kerikun11/ChargeStation/(list of files, drawings)

Other design files:
kicad/ChargeStation06.dsn
