kerikun11/ChargeStation/kicad/ChargeStation06.kicad_pcb

## KiCad design kicad/ChargeStation06.kicad_pcb (2019-02-26)

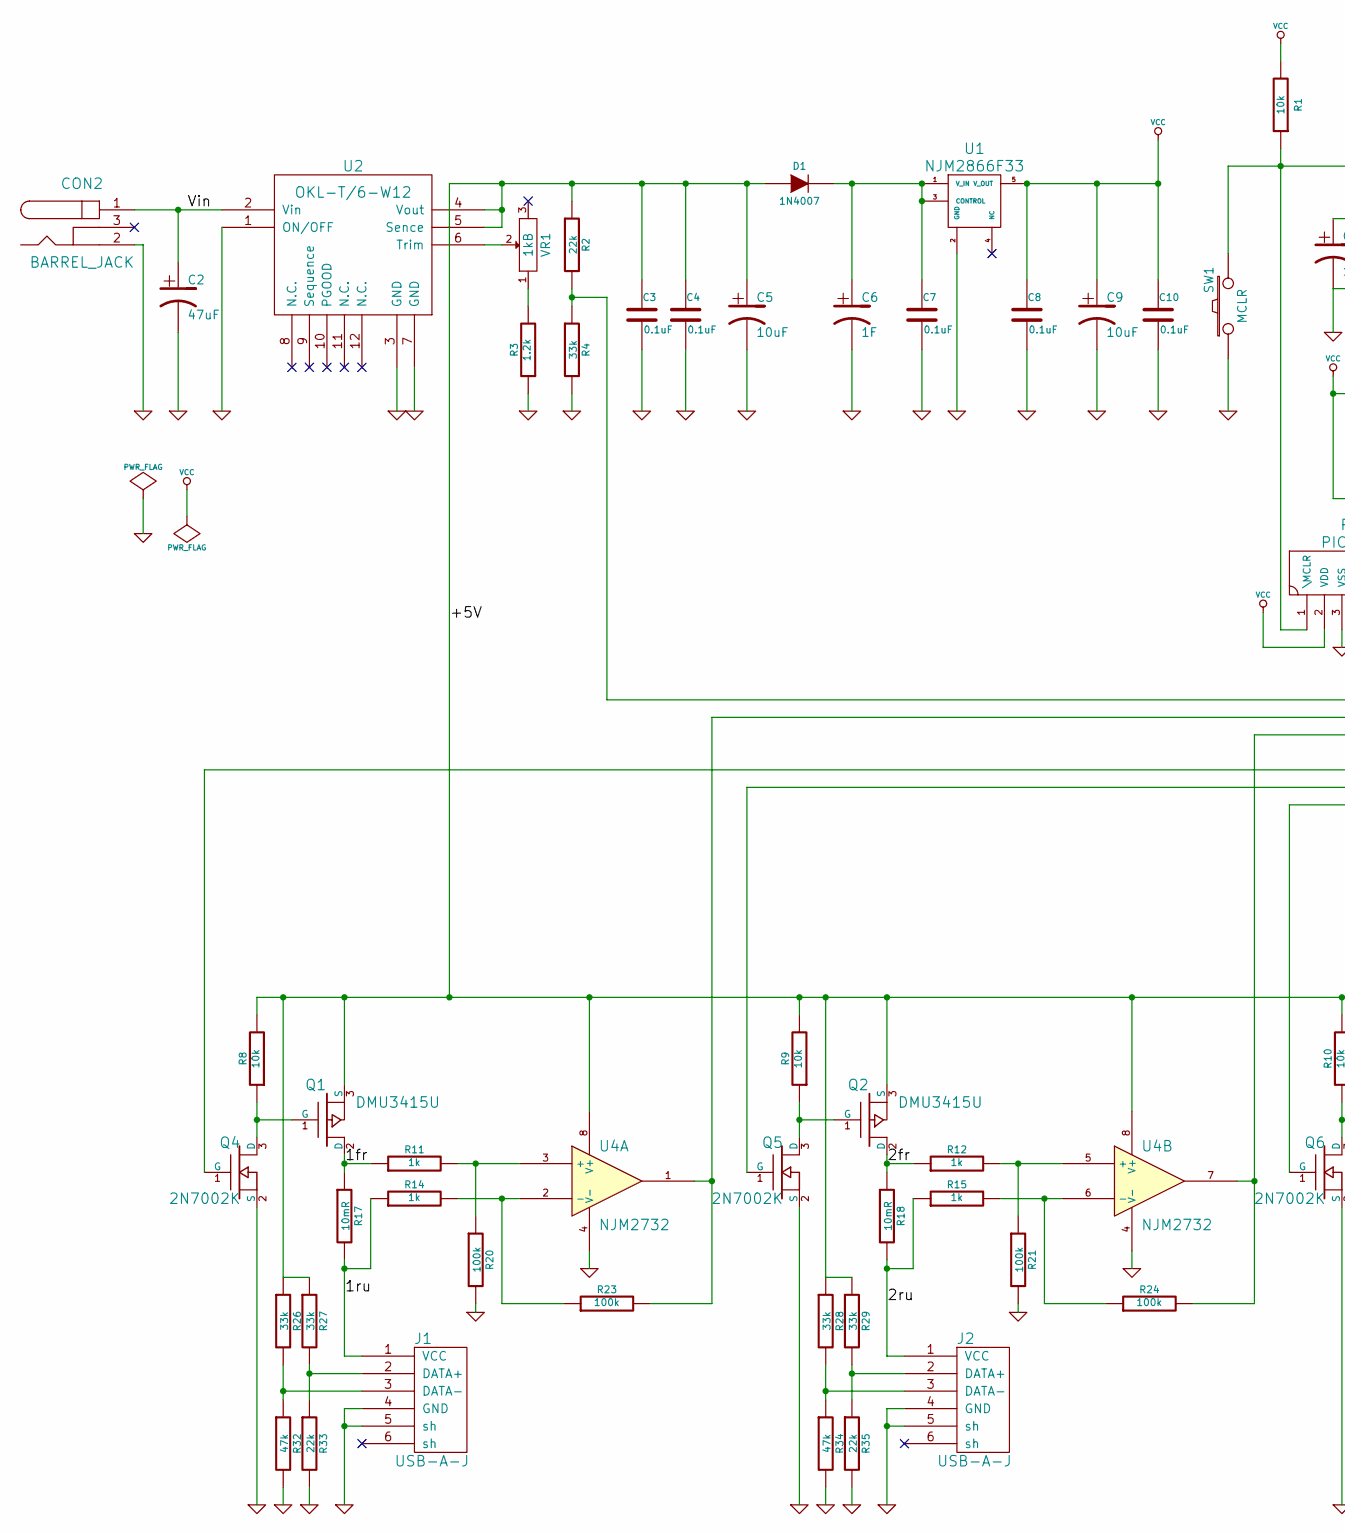
[picture p1: schematic ChargeStation06.sch, part in row 1, column 1]

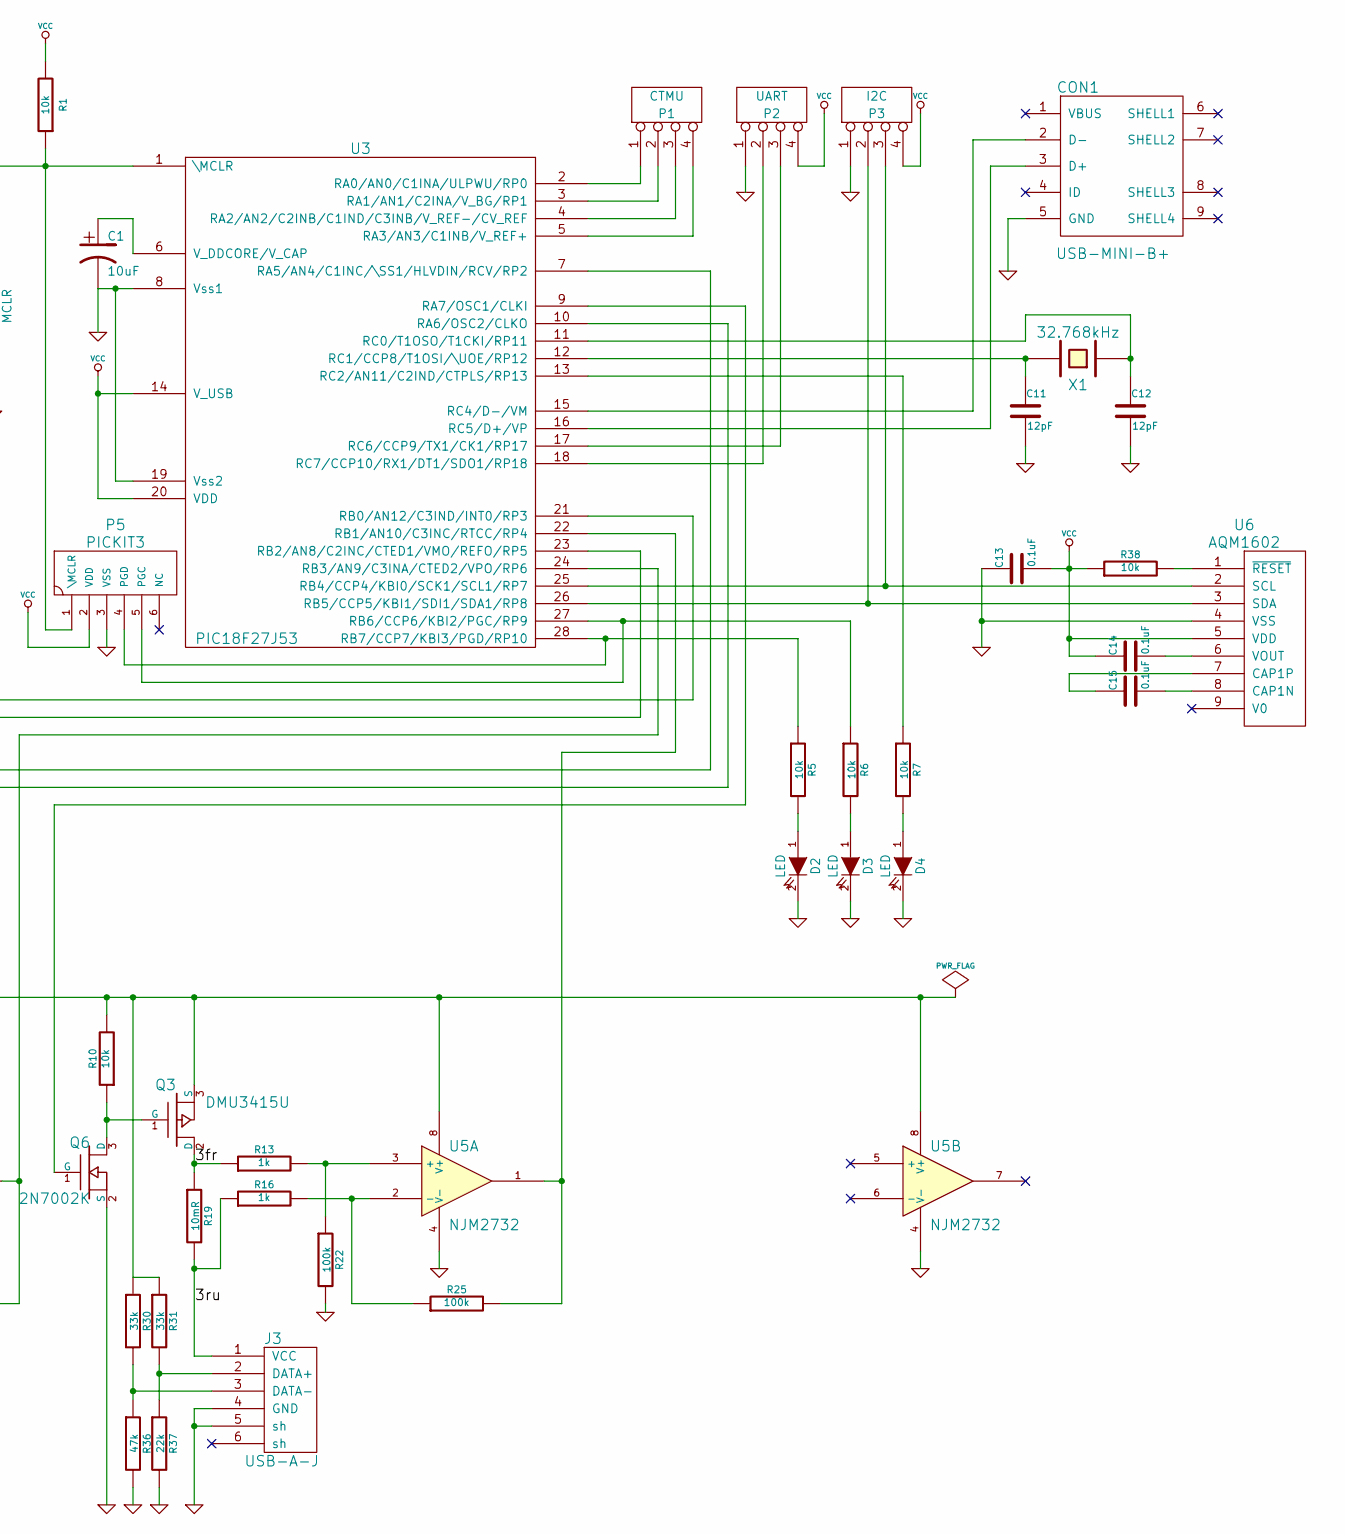
[picture p2: schematic ChargeStation06.sch, part in row 1, column 2]

Parts:
C1, C5, C9: 10uF
C2: 47uF
C3, C4, C7, C8, C10, C13, C14, C15: 0.1uF
C6: 1F
C11, C12: 12pF
CON1: USB-MINI-B+
CON2: BARREL_JACK
D1: 1N4007
D2, D3, D4: LED
J1, J2, J3: USB-A-J
P1: CTMU
P2: UART
P3: I2C
P5: PICKIT3
Q1, Q2, Q3: DMU3415U
Q4, Q5, Q6: 2N7002K
R1, R5, R6, R7, R8, R9, R10, R38: 10k
R2, R33, R35, R37: 22k
R3: 1.2k
R4, R26, R27, R28, R29, R30, R31: 33k
R11, R12, R13, R14, R15, R16: 1k
R17, R18, R19: 10mR
R20, R21, R22, R23, R24, R25: 100k
R32, R34, R36: 47k
SW1: MCLR
U1: NJM2866F33
U2: OKL-T/6-W12
U3: PIC18F27J53
U4, U5: NJM2732
U6: AQM1602
VR1: 1kB
X1: 32.768kHz

Connections:
/1fr: Q1.2 (D), R11.1, R17.1
/1ru: J1.1 (VCC), R14.1, R17.2
/2fr: Q2.2 (D), R12.1, R18.1
/2ru: J2.1 (VCC), R15.1, R18.2
/3fr: Q3.2 (D), R13.1, R19.1
/3ru: J3.1 (VCC), R16.1, R19.2
/+5V: C3.1, C4.1, C5.1, D1.1 (A), Q1.3 (S), Q2.3 (S), Q3.3 (S), R2.1, R8.2, R9.2, R10.2, R26.1, R27.1, R28.1, R29.1, R30.1, R31.1, U2.4 (Vout), U2.5 (Sence), U4.8 (V+), U5.8 (V+)
/Vin: C2.1, CON2.1, U2.2 (Vin)
GND: C1.2, C2.2, C3.2, C4.2, C5.2, C6.2, C7.2, C8.2, C9.2, C10.2, C11.2, C12.2, C13.1, CON1.5 (GND), CON2.2, D2.2 (K), D3.2 (K), D4.2 (K), J1.4 (GND), J1.5 (sh), J2.4 (GND), J2.5 (sh), J3.4 (GND), J3.5 (sh), P2.1, P3.1, P5.3 (VSS), Q4.2 (S), Q5.2 (S), Q6.2 (S), R3.1, R4.2, R20.2, R21.2, R22.2, R32.2, R33.2, R34.2, R35.2, R36.2, R37.2, SW1.1, U1.2 (GND), U2.1 (ON/OFF), U2.3 (GND), U2.7 (GND), U3.8 (Vss1), U3.19 (Vss2), U4.4 (V-), U5.4 (V-), U6.4 (VSS)
unnamed: J3.3 (DATA-), R30.2, R36.1
unnamed: J3.2 (DATA+), R31.2, R37.1
unnamed: R13.2, R22.1, U5.3 (+)
unnamed: Q2.1 (G), Q5.3 (D), R9.1
unnamed: R24.2, U3.24 (RB3/AN9/C3INA/CTED2/VPO/RP6), U4.7
unnamed: R15.2, R24.1, U4.6 (-)
unnamed: Q3.1 (G), Q6.3 (D), R10.1
unnamed: R25.2, U3.22 (RB1/AN10/C3INC/RTCC/RP4), U5.1
unnamed: R16.2, R25.1, U5.2 (-)
unnamed: Q1.1 (G), Q4.3 (D), R8.1
unnamed: R23.2, U3.23 (RB2/AN8/C2INC/CTED1/VMO/REFO/RP5), U4.1
unnamed: R14.2, R23.1, U4.2 (-)
unnamed: R2.2, R4.1, U3.21 (RB0/AN12/C3IND/INT0/RP3)
unnamed: J2.3 (DATA-), R28.2, R34.1
unnamed: J2.2 (DATA+), R29.2, R35.1
unnamed: R12.2, R21.1, U4.5 (+)
unnamed: Q6.1 (G), U3.9 (RA7/OSC1/CLKI)
unnamed: CON1.2 (D-), U3.15 (RC4/D-/VM)
unnamed: R7.1, U3.13 (RC2/AN11/C2IND/CTPLS/RP13)
unnamed: P2.3, U3.17 (RC6/CCP9/TX1/CK1/RP17)
unnamed: P2.2, U3.18 (RC7/CCP10/RX1/DT1/SDO1/RP18)
unnamed: Q5.1 (G), U3.10 (RA6/OSC2/CLKO)
unnamed: Q4.1 (G), U3.7 (RA5/AN4/C1INC/\SS1/HLVDIN/RCV/RP2)
unnamed: P1.1, U3.2 (RA0/AN0/C1INA/ULPWU/RP0)
unnamed: P1.2, U3.3 (RA1/AN1/C2INA/V_BG/RP1)
unnamed: P1.4, U3.5 (RA3/AN3/C1INB/V_REF+)
unnamed: P5.1 (\MCLR), R1.1, SW1.2, U3.1 (\MCLR)
unnamed: P5.4 (PGD), R5.1, U3.28 (RB7/CCP7/KBI3/PGD/RP10)
unnamed: C1.1, U3.6 (V_DDCORE/V_CAP)
unnamed: C11.1, U3.12 (RC1/CCP8/T1OSI/\UOE/RP12), X1.2
unnamed: P5.5 (PGC), R6.1, U3.27 (RB6/CCP6/KBI2/PGC/RP9)
unnamed: C15.1, U6.7 (CAP1P)
unnamed: P3.3, U3.25 (RB4/CCP4/KBI0/SCK1/SCL1/RP7), U6.2 (SCL)
unnamed: P3.2, U3.26 (RB5/CCP5/KBI1/SDI1/SDA1/RP8), U6.3 (SDA)
unnamed: R38.2, U6.1 (~RESET)
unnamed: C14.2, U6.6 (VOUT)
unnamed: C15.2, U6.8 (CAP1N)
unnamed: J1.2 (DATA+), R27.2, R33.1
unnamed: J1.3 (DATA-), R26.2, R32.1
unnamed: R11.2, R20.1, U4.3 (+)
unnamed: P1.3, U3.4 (RA2/AN2/C2INB/C1IND/C3INB/V_REF-/CV_REF)
unnamed: D3.1 (A), R6.2
unnamed: CON1.3 (D+), U3.16 (RC5/D+/VP)
unnamed: U2.6 (Trim), VR1.2
unnamed: D2.1 (A), R5.2
unnamed: D4.1 (A), R7.2
unnamed: R3.2, VR1.1
unnamed: C6.1, C7.1, D1.2 (K), U1.1 (V_IN), U1.3 (CONTROL)
unnamed: C12.1, U3.11 (RC0/T1OSO/T1CKI/RP11), X1.1
VCC: C8.1, C9.1, C10.1, C13.2, C14.1, P2.4, P3.4, P5.2 (VDD), R1.2, R38.1, U1.5 (V_OUT), U3.14 (V_USB), U3.20 (VDD), U6.5 (VDD)

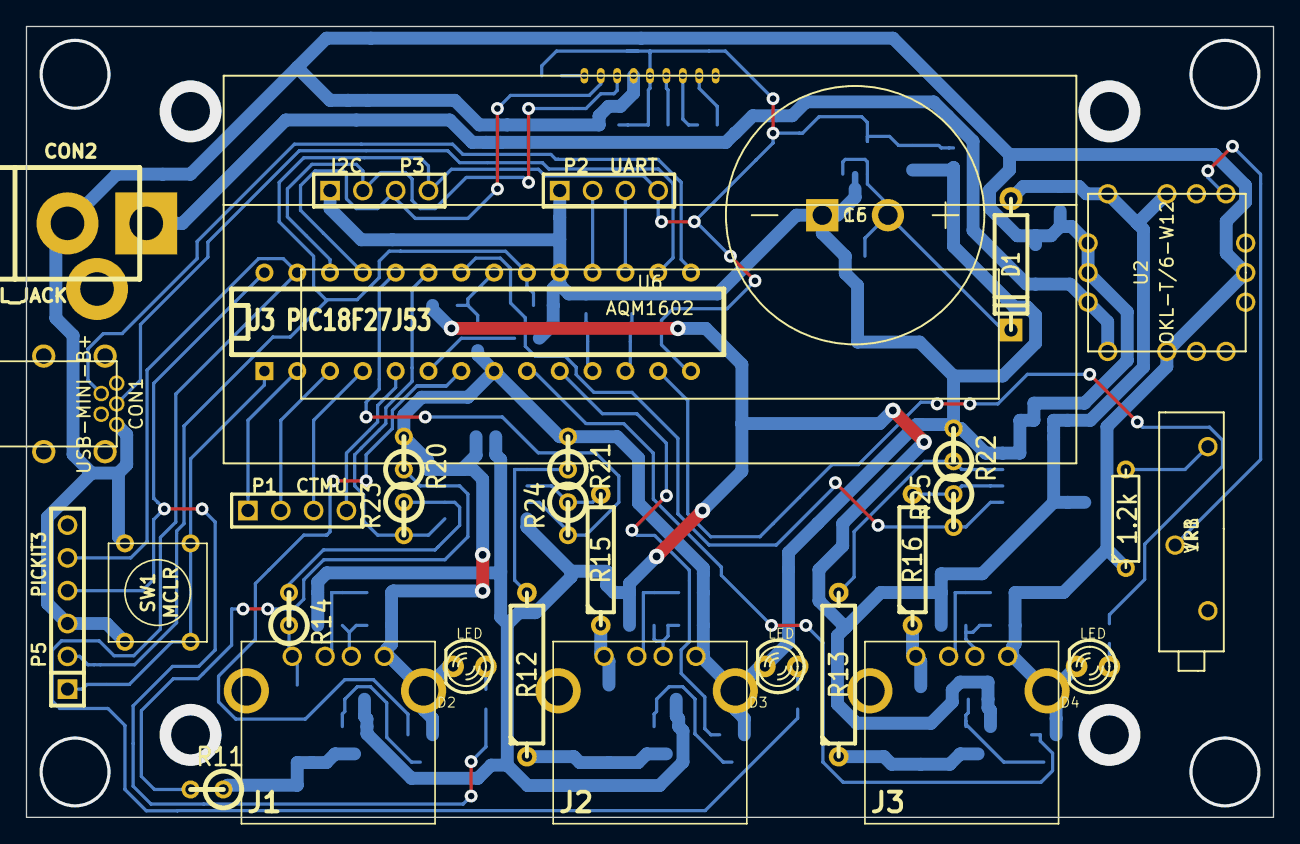
[picture p3: board ChargeStation06.kicad_pcb from above]

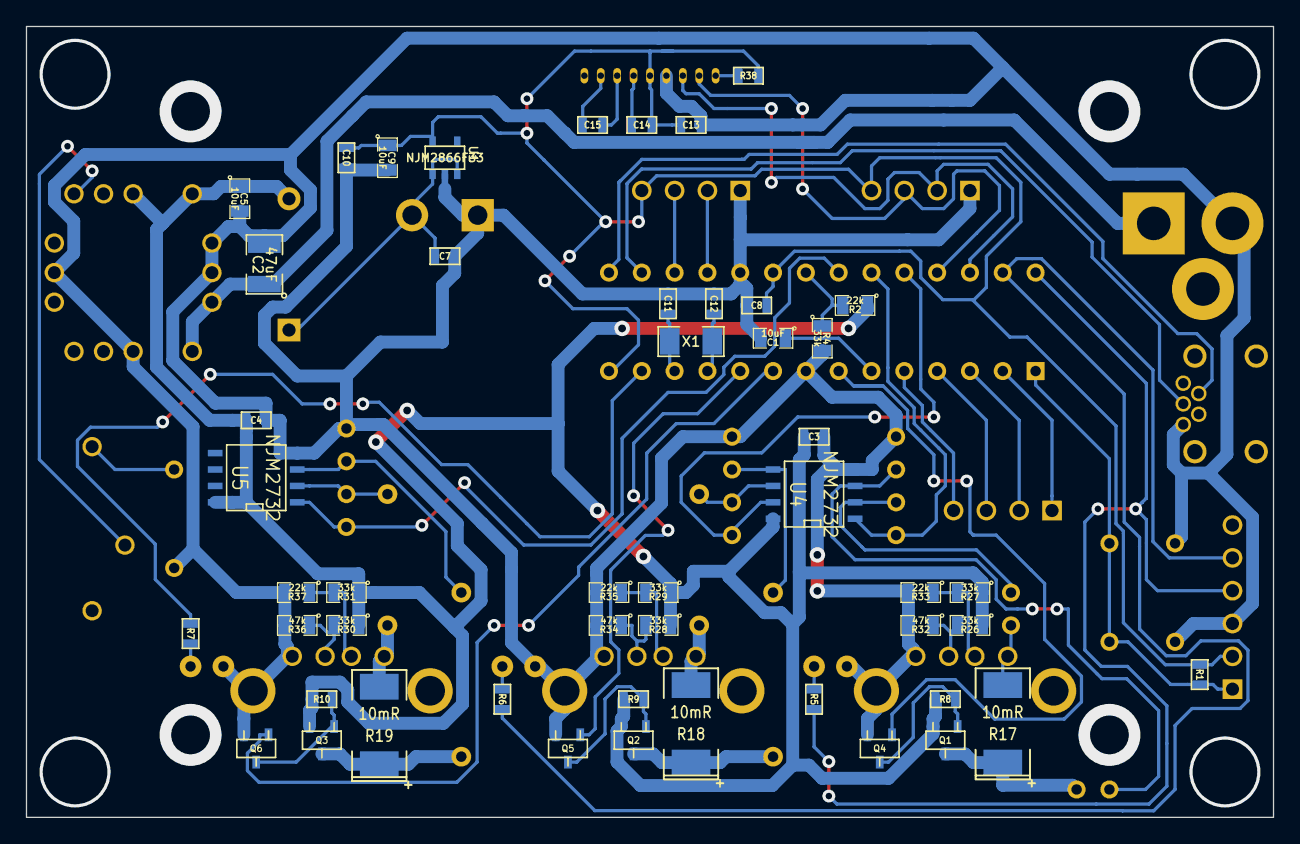
[picture p4: board ChargeStation06.kicad_pcb from below]

Board: 2 copper layers, 96.5 x 61.2 mm, 81 parts (49 on the bottom side), 59 nets.
